Minhbui0212/Speaker-Circuit/(list of files, drawings)

Other design files:
Mạch loa khuếch đại âm thanh/BTL_DDTTT1-N4.pdsprj
